lambilly/ESP-ASR-Speaker/docs/bom.csv

Refs | Value | Footprint | Qty
C1,C3,C6 | 10μF/10V | Capacitor_THT:CP_Radial_D5.0mm_P2.50mm | 3
C2 | 22μF/10V | Capacitor_THT:CP_Radial_D5.0mm_P2.50mm | 1
C4,C5,C7,C8 | 0.1μF/50V | Capacitor_THT:C_Disc_D5.0mm_W2.5mm_P2.50mm | 4
J1 | MAX98357A | Connector_PinSocket_2.54mm:PinSocket_1x07_P2.54mm_Vertical | 1
J_ASRA1 | ASRPRO 4M | Connector_PinSocket_2.54mm:PinSocket_1x09_P2.54mm_Vertical | 1
J_ASRB1 |  | Connector_PinSocket_2.54mm:PinSocket_1x09_P2.54mm_Vertical | 1
J_ASR_SPK1 | SPK | Connector_JST:JST_PH_B2B-PH-K_1x02_P2.00mm_Vertical | 1
J_ASR_UART1 | ASRPRO TTL | Connector_PinHeader_2.54mm:PinHeader_1x04_P2.54mm_Vertical | 1
J_BATT1 | 电池输入 | Connector_PinHeader_2.54mm:PinHeader_1x02_P2.54mm_Vertical | 1
J_BATT_SW1 | 电池开关 | Connector_PinHeader_2.54mm:PinHeader_1x02_P2.54mm_Vertical | 1
J_ESPA1 | ESP32-WROVER-E | Connector_PinSocket_2.54mm:PinSocket_1x19_P2.54mm_Vertical | 1
J_ESPB1 | Conn_01x19_Socket | Connector_PinSocket_2.54mm:PinSocket_1x19_P2.54mm_Vertical | 1
J_KEY_SW1 | LED开关 | Connector_JST:JST_PH_B2B-PH-K_1x02_P2.00mm_Vertical | 1
J_KEY_SW2 | 功能开关 | Connector_JST:JST_PH_B2B-PH-K_1x02_P2.00mm_Vertical | 1
J_LED_BUS1 | LED灯带 | Connector_JST:JST_PH_B3B-PH-K_1x03_P2.00mm_Vertical | 1
J_MIC1 | MIC | Connector_JST:JST_PH_B2B-PH-K_1x02_P2.00mm_Vertical | 1
J_POWER1 | IP5306模块 | Connector_PinSocket_2.54mm:PinSocket_1x06_P2.54mm_Vertical | 1
J_SPK1,J_SPK_OUT1 | Speaker | Connector_JST:JST_PH_B2B-PH-K_1x02_P2.00mm_Vertical | 2
J_VCC1 | 电源输入 | Connector_PinHeader_2.54mm:PinHeader_1x02_P2.54mm_Vertical | 1
R1 | 220Ω | Resistor_THT:R_Axial_DIN0207_L6.3mm_D2.5mm_P10.16mm_Horizontal | 1
R2,R3 | 10KΩ | Resistor_THT:R_Axial_DIN0207_L6.3mm_D2.5mm_P10.16mm_Horizontal | 2
R4 | 4.7KΩ | Resistor_THT:R_Axial_DIN0207_L6.3mm_D2.5mm_P10.16mm_Horizontal | 1
U1 | DS18B20 | Package_TO_SOT_THT:TO-92_Inline | 1
