lambilly/ESP-ASR-Speaker/docs/schematic.pdf

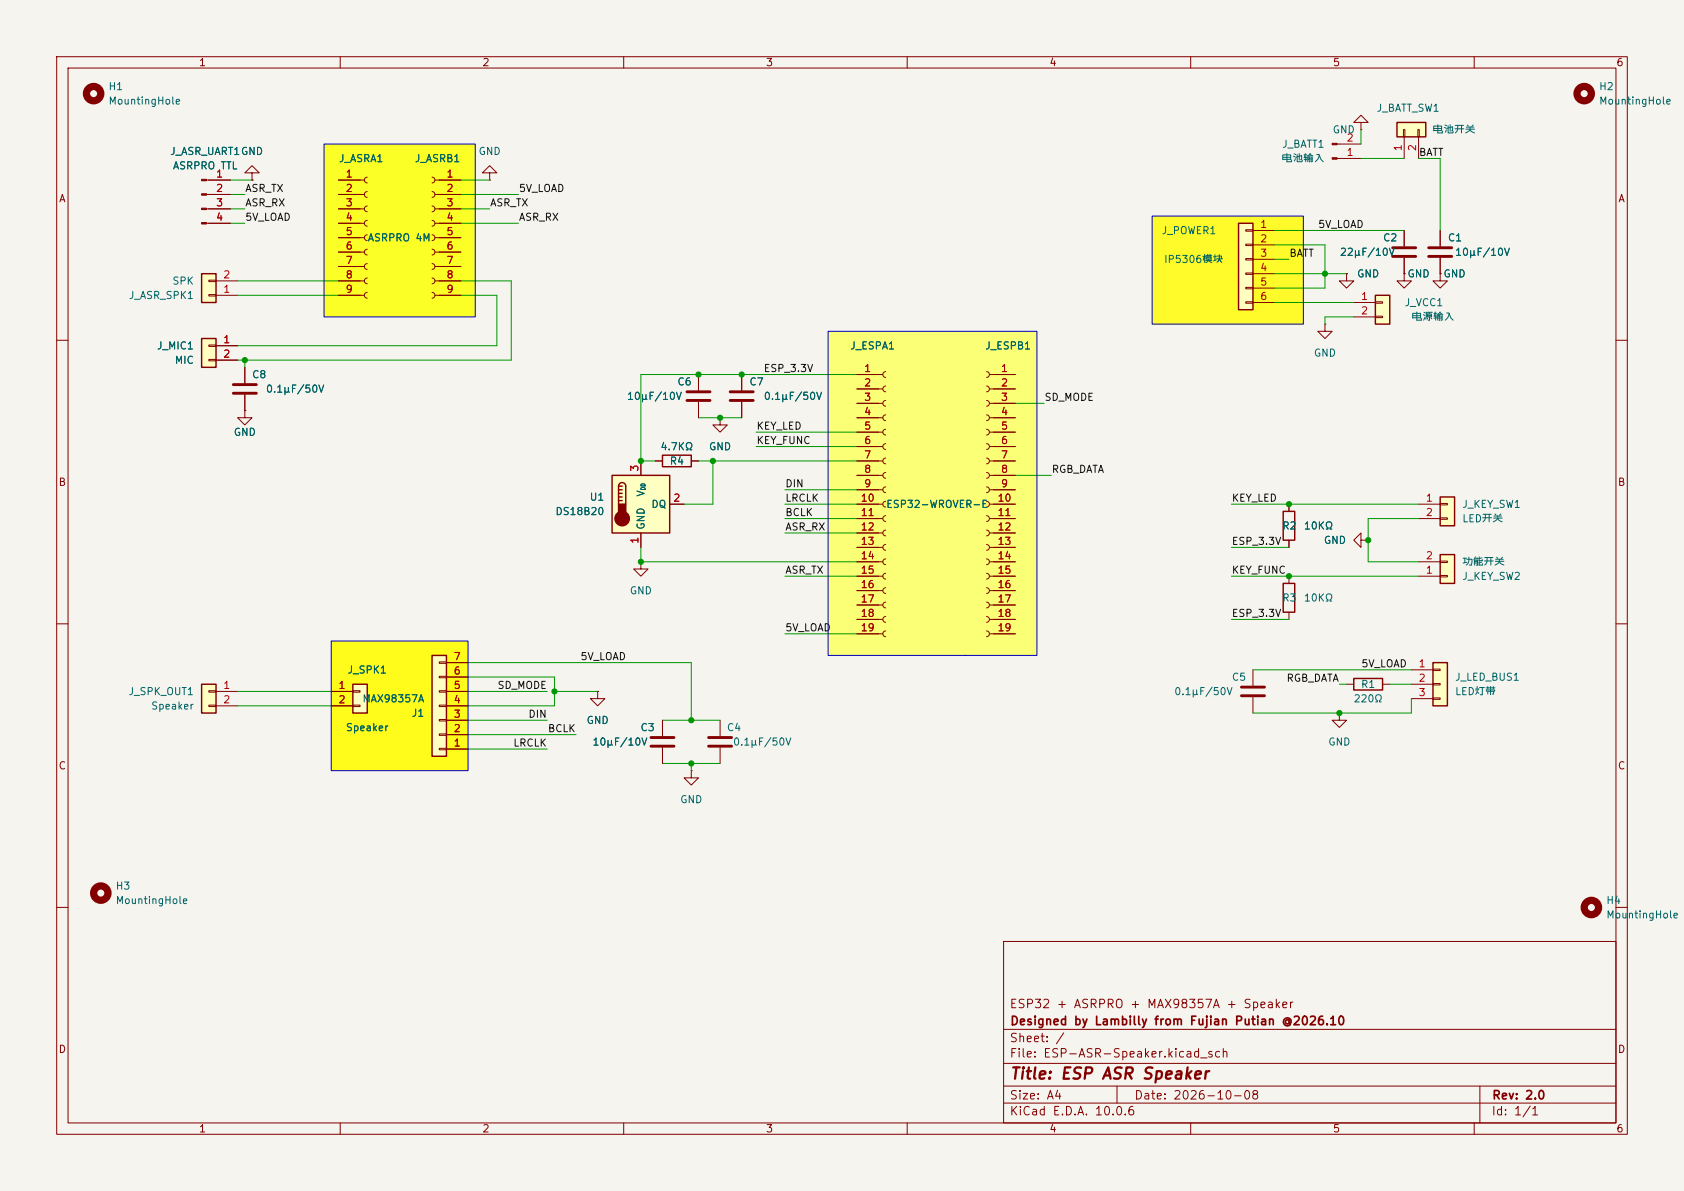
[picture p2: page 1]

ESP32 + ASRPRO + MAX98357A + Speaker
Designed by Lambilly from Fujian Putian @2026.10
Sheet: /
File: ESP-ASR-Speaker.kicad_sch
Title: ESP ASR Speaker

Size: A4 | Rev: 2.0
KiCad E.D.A. 10.0.6 | Id: 1/1
