lambilly/ESP-ASR-Speaker/hardware/ESP-ASR-Speaker.kicad_pcb

## KiCad design hardware/ESP-ASR-Speaker.kicad_pcb (2026-11-04)

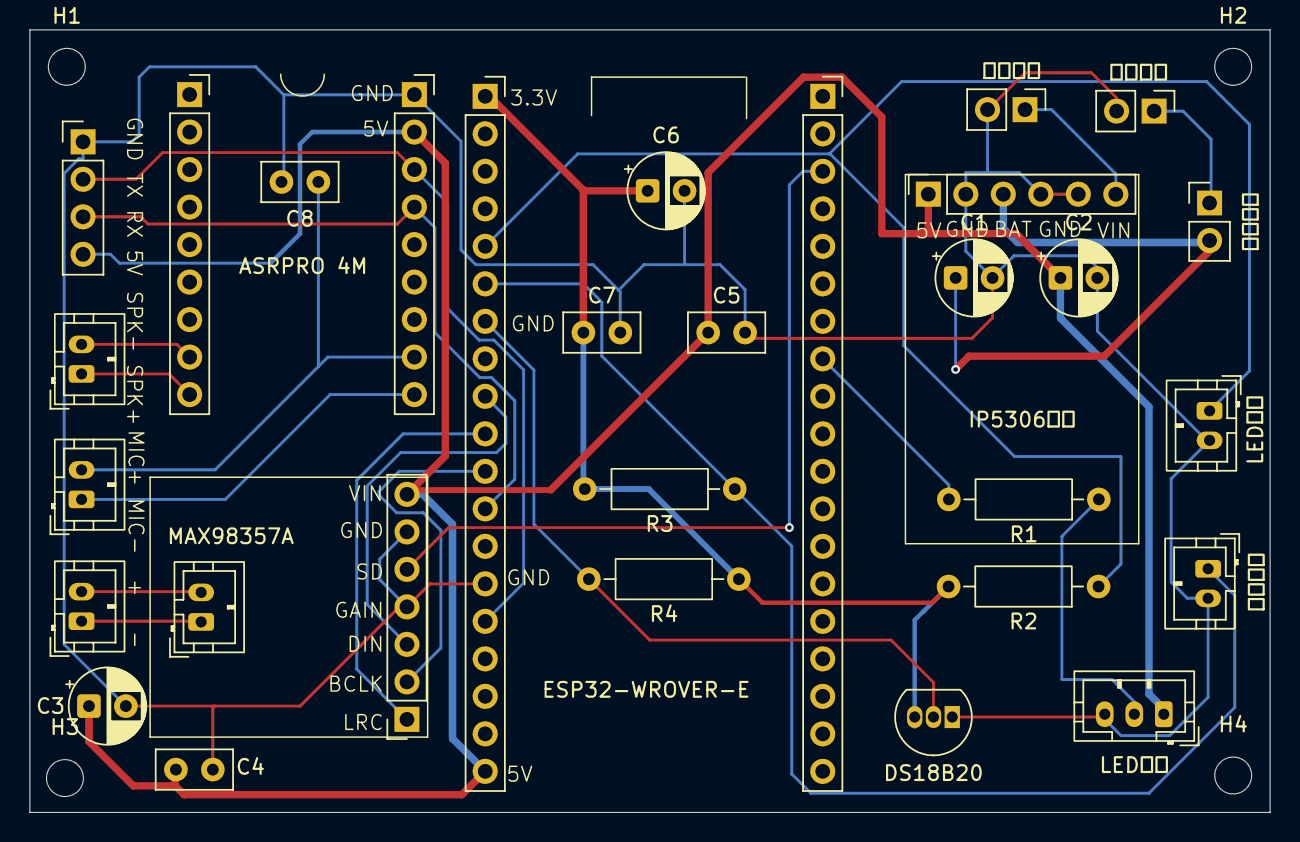
[picture p3: board ESP-ASR-Speaker.kicad_pcb from above]

Board: 2 copper layers, 84.0 x 53.0 mm, 34 parts (0 on the bottom side), 23 nets.

Parts:
C1, C3, C6: 10μF; CP_Radial_D5.0mm_P2.50mm
C2: 22μF; CP_Radial_D5.0mm_P2.50mm
C4, C5, C7, C8: 0.1μF; C_Disc_D5.0mm_W2.5mm_P2.50mm
H1, H2, H3, H4: MountingHole; MountingHole_2.5mm
J1: MAX98357A; PinSocket_1x07_P2.54mm_Vertical
J_ASRA1: ASRPRO 4M; PinSocket_1x09_P2.54mm_Vertical
J_ASRB1: PinSocket_1x09_P2.54mm_Vertical
J_ASR_SPK1: SPK; JST_PH_B2B-PH-K_1x02_P2.00mm_Vertical
J_ASR_UART1: ASRPRO TTL; PinHeader_1x04_P2.54mm_Vertical
J_BATT1: 电池输入; PinHeader_1x02_P2.54mm_Vertical
J_BATT_SW1: 电池开关; PinHeader_1x02_P2.54mm_Vertical
J_ESPA1: ESP32-WROVER-E; PinSocket_1x19_P2.54mm_Vertical
J_ESPB1: Conn_01x19_Socket; PinSocket_1x19_P2.54mm_Vertical
J_KEY_SW1: LED开关; JST_PH_B2B-PH-K_1x02_P2.00mm_Vertical
J_KEY_SW2: 功能开关; JST_PH_B2B-PH-K_1x02_P2.00mm_Vertical
J_LED_BUS1: LED灯带; JST_PH_B3B-PH-K_1x03_P2.00mm_Vertical
J_MIC1: MIC; JST_PH_B2B-PH-K_1x02_P2.00mm_Vertical
J_POWER1: IP5306模块; PinSocket_1x06_P2.54mm_Vertical
J_SPK1: Speaker; JST_PH_B2B-PH-K_1x02_P2.00mm_Vertical
J_SPK_OUT1: Speaker; JST_PH_B2B-PH-K_1x02_P2.00mm_Vertical
J_VCC1: 电源输入; PinHeader_1x02_P2.54mm_Vertical
R1: 220Ω; R_Axial_DIN0207_L6.3mm_D2.5mm_P10.16mm_Horizontal
R2, R3: 10KΩ; R_Axial_DIN0207_L6.3mm_D2.5mm_P10.16mm_Horizontal
R4: 4.7KΩ; R_Axial_DIN0207_L6.3mm_D2.5mm_P10.16mm_Horizontal
U1: DS18B20; TO-92_Inline

Connections:
/5V_LOAD: C2.1, C3.1, C4.1, C5.1, J1.7, J_ASRB1.2, J_ASR_UART1.4, J_ESPA1.19, J_LED_BUS1.1, J_POWER1.1
/ASR_RX: J_ASRB1.4, J_ASR_UART1.3, J_ESPA1.12
/ASR_TX: J_ASRB1.3, J_ASR_UART1.2, J_ESPA1.15
/BATT: C1.1, J_BATT_SW1.2, J_POWER1.3
/BCLK: J1.2, J_ESPA1.11
/DIN: J1.3, J_ESPA1.9
/ESP_3.3V: C6.1, C7.1, J_ESPA1.1, R2.2, R3.2, R4.1, U1.3 (V_{DD})
/KEY_FUNC: J_ESPA1.6, J_KEY_SW2.1, R3.1
/KEY_LED: J_ESPA1.5, J_KEY_SW1.1, R2.1
/LRCLK: J1.1, J_ESPA1.10
/RGB_DATA: J_ESPB1.8, R1.2
/SD_MODE: J1.5, J_ESPB1.3
GND: C1.2, C2.2, C3.2, C4.2, C5.2, C6.2, C7.2, C8.2, J1.4, J1.6, J_ASRB1.1, J_ASR_UART1.1, J_BATT1.2 (BAT-), J_ESPA1.14, J_KEY_SW1.2, J_KEY_SW2.2, J_LED_BUS1.3, J_POWER1.2, J_POWER1.4, J_POWER1.5, J_VCC1.2 (GND), U1.1 (GND)
unnamed: J_ASRA1.8, J_ASR_SPK1.2 (SPK+)
unnamed: J_ASRA1.9, J_ASR_SPK1.1 (SPK-)
unnamed: C8.1, J_ASRB1.8, J_MIC1.2 (MIC+)
unnamed: J_ASRB1.9, J_MIC1.1 (MIC-)
unnamed: J_BATT1.1 (BAT+), J_BATT_SW1.1
unnamed: J_ESPA1.7, R4.2, U1.2 (DQ)
unnamed: J_LED_BUS1.2, R1.1
unnamed: J_POWER1.6, J_VCC1.1 (VCC)
unnamed: J_SPK1.1, J_SPK_OUT1.1
unnamed: J_SPK1.2, J_SPK_OUT1.2
