lambilly/ESP-ASR-Speaker/(commit log)

2026-11-04 feat: ESP ASR Speaker — 离线语音识别音箱（硬件 + 固件）
    硬件（hardware/）
    - KiCad 10 工程：84×53mm 两块板，ESP32-WROVER + ASRPRO + MAX98357 + IP5306
    - 含 35 元件原理图、PCB 布局与 254 条走线
    - 导出物：schematic.pdf、pcb-top.svg、bom.csv（无价格）
    固件（firmware/）
    - ESPHome 单管线音频：i2s_audio + speaker_source（MP3/48k/mono）
    - 音源切换：TTS / 蓝牙 A2DP / HTTP 音频
    - 30 颗 WS2812 集中式 LED 状态机（9 状态，静音>过热>蓝牙>TTS>待机）
    - ASRPRO 串口指令解析、DS18B20 温度联动、双键多击交互
    - 所有密钥走 secrets.yaml（已 gitignore），提供 secrets.yaml.example
    文档（docs/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
    [ESP-ASR-Speaker.kicad_pcb, ESP-ASR-Speaker.kicad_sch, bom.csv]
2026-11-04 chore: 添加 .gitattributes 统一换行符
2026-11-04 docs: 撤下第三方产品效果图，外壳来源改为通用描述
    - 删除 docs/images/hero-2.jpg（出处为音箱套件商品图，版权不明）
    - README 中「王笑尘音箱」改写为「铝合金翻页时钟音箱外壳」，避免为第三方商品导流
    - 顶部成品图保留本人实拍（机内已装本项目主板）
2026-11-04 docs: 注明成品图与演示视频为作者本人拍摄
